IgorFJensen/Hard-EnvSens/TODO.txt

Recomendaçoes para a placa enviroment sensor

Estrutura:
    1- Tirar o chip do esp do meio da placa (antena)
    2- Se caso a proxima placa forem 2 separadas novamente, criar suporte nas extremidades para a plaquinha que fica em cima, pois se forcar ela pode quebrar os headers

Erros na placa ATUAL, lembrar de trocar:
    Utilizar o regulador de tensao 1.8 para alimentar o SHTC1
    Sensor de 1.8 nao funciona e nao descobri o motivo (possivelmente trocar para outro)
    Alimentar o pino VDDH do SGP40
    Trocar os pinos do esp para o esp que vamos utilizar
    Verificar o voltage level translator

Sensores:
