IgorFJensen/Hard-EnvSens/EnvSens-v1.pdf

# Nordic nRF52840

# Sensors

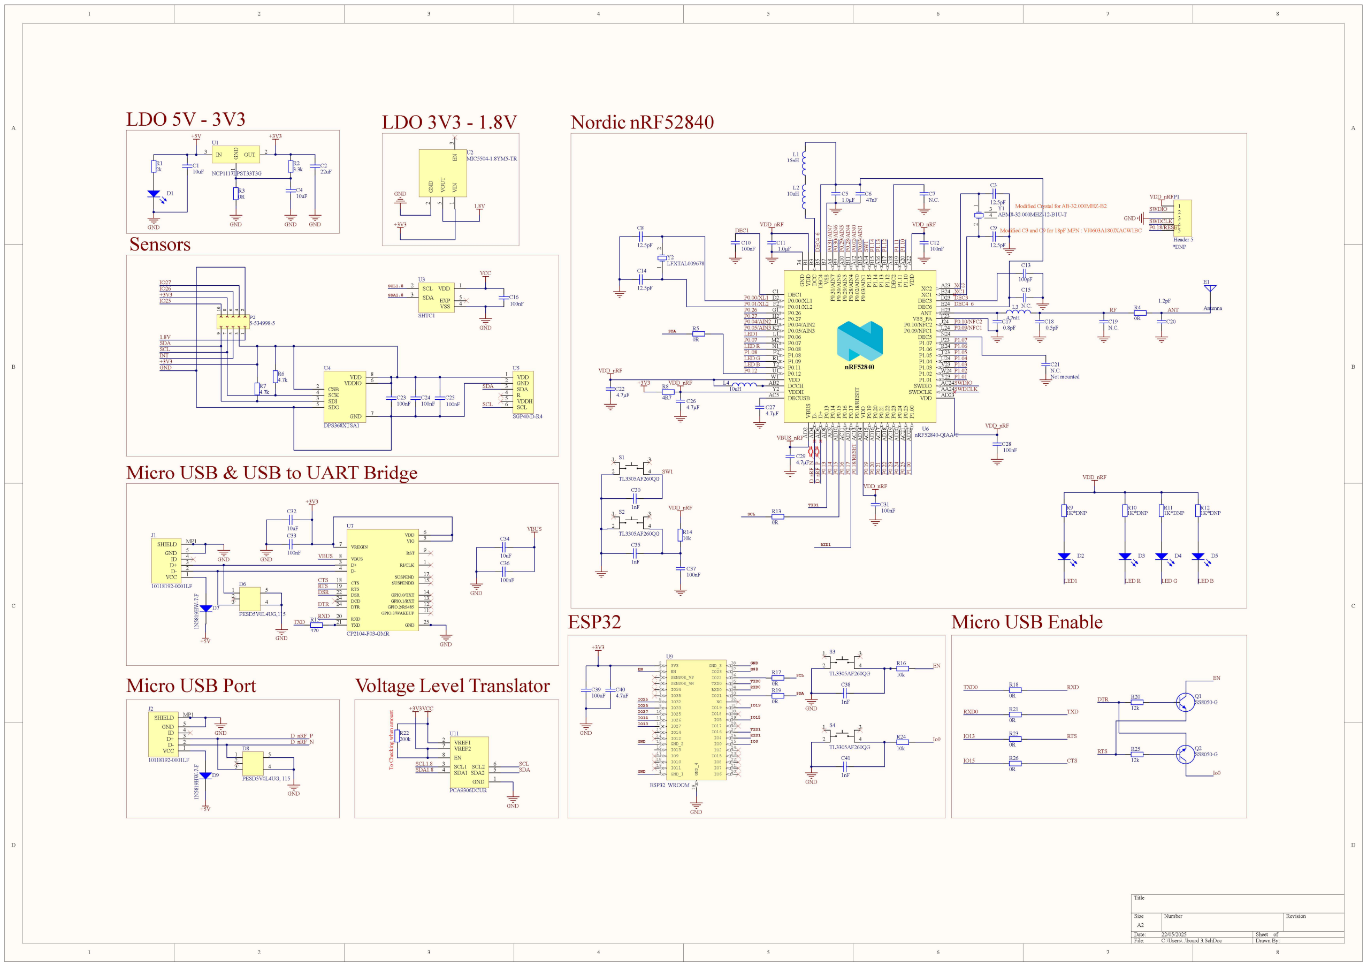
[picture p1: page 1]

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
Title

Size | Number | Revision
A2
Date: | 22/05/2025 | Sheet of
File: | C:\Users\..\board 3.SchDoc | Drawn By:

ANT

1.2pF

C20

DEC1 C1

VDD W1

VSS_PA | F23 ANT | H23 DEC6 | E24 DEC3 | D23 XC1 | B24 XC2 VDD | A23 A²² P¹.10 A²⁰

P0.00/XL1 D2

P0.01/XL2 F2 | P⁰.28/AIN⁴ B¹¹ DEC⁴ B⁵ VSS B⁷ VDD B¹ DCC B³
SWDCLK | AA24 SWDIO | AC24 P1.01 | Y23 D⁻ AD⁴ | P⁰.19 AC¹⁵

### nRF52840

VDDH Y2 | DCCH AB2 | VBUS AD²
DECUSB AC5 | D⁺ AD⁶ | P⁰.20 AD¹⁶ P⁰.21 AC¹⁷ P⁰.22 AD¹⁸ P⁰.23 AC¹⁹ P⁰.24 AD²⁰
VDD | AD23
P0.09/NFC1 | L24
P1.09 R1 | P⁰.25 AC²¹ P¹.00 AD²²

P0.26 G1
P0.27 H2
P0.04/AIN2 J1
P0.05/AIN3 K2
P0.06 L1
P0.07 M2
P0.08 N1
P1.08 P2 | P⁰.13 AD⁸ P⁰.14 AC⁹ P⁰.15 AD¹⁰ P⁰.16 AC¹¹

P0.11 T2
P0.12 U1 | P⁰.17 AD¹² P⁰.18/RESET AC¹³
DEC5 | N24
P0.10/NFC2 | J24 P⁰.03/AIN¹ B¹³ P⁰.02/AIN⁰ A¹² P⁰.29/AIN⁵ A¹⁰ P⁰.30/AIN⁶ B⁹ P⁰.31/AIN⁷ A⁸ | VDD AD¹⁴
P1.02 | W24 P1.03 | V23 P1.04 | U24 P1.05 | T23 P1.06 | R24 P1.07 | P23 P¹.11 B¹⁹ P¹.12 B¹⁷ P¹.13 A¹⁶ P¹.14 B¹⁵ P¹.15 A¹⁴ | DEC² A¹⁸ GND ⁷⁴

U6
nRF52840-QIAA-T

100pF

C13

100nF

C10

4.7µF

C27

XC1

XC2

VDD_nRF

P0.07

P0.10/NFC2

P0.12 | P⁰.18/RESET | P⁰.19 P⁰.20 P⁰.21 P⁰.22 P⁰.23 | P¹.00 P¹.10

DEC1

SWDCLK

SWDIO

1.0µF

C5

0.8pF

C17

C15

N.C.

P0.00/XL1

P0.01/XL2 | P⁰.02/AIN⁰ P⁰.03/AIN¹

VBUS_nRF

VDD_nRF

DEC3

P0.04/AIN2

P0.05/AIN3 | P0.09/NFC1 P¹.14 P¹.13 P¹.12 | P¹.11

VDD_nRF

VDD_nRF

100nF

C31

4.7µF

C29

VDD_nRF

100nF

C28

Not mounted

C21
N.C.
P1.01

P1.02

P1.03

P1.04

P1.05

P1.07

P1.08

P0.26

P0.27 | P⁰.13 P⁰.14 P⁰.15 P⁰.16 P⁰.17 | P⁰.24 P⁰.25

100nF

C12

VDD_nRF

C7

N.C. P⁰.31/AIN⁷ P⁰.30/AIN⁶ P⁰.29/AIN⁵ P⁰.28/AIN⁴

4.7µF

C26

0.5pF

C18

1.0µF

C11

4.7µF

C22

47nF

C6

DEC4_6 DEC⁴_6

RF

C19

N.C. ¹ ²
3
4

Y1
ABM8-32.000MHZ-12-B1U-T

12.5pF

C14 | 1 2 | Y2
| | LFXTAL009678

12.5pF

C8

12.5pF

C9

12.5pF

C3

0R

R5 SDA

0R

R13 SCL

4R7

R8 +3V3

1
2
3
4
5

*DNP

P1

Header 5

VDD_nRF

SWDIO
GND | SWDCLK
| P0.18/RESET

1K*DNP

R10
1K*DNP

R11
1K*DNP

R12
1K*DNP

R9

VDD_nRF

LED1

LED R

LED G
LED B
LED1 | LED R | LED G | LED B

1nF

C30

1nF

C35

SW1

100nF

C37

10k

R14

VDD_nRF

E1

Antenna

0R

R4 D_nRF_N D_nRF_P RXD1 GND

### 2 VIN

### 1 VOUT

# 5 EN

3
U2
MIC5504-1.8YM5-TR

GND

+3V3

1.8V

2

1 3

4

S1

TL3305AF260QG

2

1 3

4

S2

TL3305AF260QG

D2 | D3 | D4 | D5

SCL 2
SDA 3
VDD | 1
VSS | 4
EXP | 5

U3

SHTC1

SCL1.8

SDA1.8

GND

VCC

2

1 3

4

S3

TL3305AF260QG

2

1 3

4

S4

TL3305AF260QG

GND

100nF

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
VDD | 8
VDDIO | 6
GND | 7

CSB 2
SCK 4
SDI 3
SDO 5

U4

DPS368XTSA1 ¹⁰
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
5-534998-5

100nF

C25

VDD 1
GND 2
SDA 3
R

4
VDDH 5
SCL 6

U5

SGP40-D-R4

SDA

100nF | SCL

C24
100nF

C23

IO27
IO26
+3V3
IO25

SDA
SCL
INT
+3V3
GND

TXD0

RXD0

IO13

IO15

RXD

TXD

RTS

CTS

VREF1 2
VREF2 7
EN 8
SCL1 3
SDA1 4
GND | 1
SDA2 | 5
SCL2 | 6

U11

PCA9306DCUR

+3V3VCC

SCL1.8
SDA1.8

SCL
SDA

GND

VREGIN 7

VDD | 6
VIO | 5
RST | 9
VBUS 8
D+ 3
D- 4

RI/CLK 1

CTS 18
RTS 19
DSR 22
DCD 24
DTR 24
GPIO.3/WAKEUP | 11 GPIO.2/RS485 | 12 GPIO.1/RXT | 13 GPIO.0/TXT | 14
SUSPEND | | | | 17
SUSPENDB | | | | 15
TXD 21 | RXD 20
GND | 25

U7

CP2104-F03-GMR

1

3

5
2
4

D6

PESD5V0L4UG,115

SHIELD | MP1
GND | 5
ID | 4
D+ | 3
D- | 2
VCC | 1

J1

10118192-0001LF

GND

+5V | GND

TXD

RXD

DTR

DSR

RTS

CTS

VBUS 100nF

C33

10uF

C32

GND

+3V3

GND

100nF

C36

GND

VBUS

10uF

C34

# Micro USB & USB to UART Bridge

SHIELD | MP1
GND | 5
ID | 4
D+ | 3
D- | 2
VCC | 1

J2

10118192-0001LF

1

3

5
2
4

D8

PESD5V0L4UG, 115

GND

+5V

D_nRF_P
D_nRF_N
Micro USB Port | Voltage Level Translator

GND_1 1

3V3 2
EN 3

GND_2 15

IO11 19
IO6 | 20
IO7 | 21
IO8 | 22
IO15 | 23
IO2 | 24
IO0 | 25
IO4 | 26
IO16 | 27
IO17 | 28
IO5 | 29
IO18 | 30
IO19 | 31
NC | 32
IO21 | 33
RXD0 | 34
TXD0 | 35
IO22 | 36
IO23 | 37
GND_3 | 38 GND_4 39

SENSOR_VP 4
SENSOR_VN 5
IO34 6
IO35 7
IO32 8
IO33 9
IO25 10
IO26 11
IO27 12
IO14 13
IO12 14

IO13 16
IO9 17
IO10 18

U9

ESP32_WROOM

0R

R17

0R

R19

SCL

SDA

TXD0
RXD0

GND
N$8

IO19

IO15

IO0

GND

GND

EN

4.7uF

C40
100uF

C39

GND

GND

+3V3

Q1
SS8050-G

# LDO 3V3 - 1.8V

IN 3 | GND

1

OUT 2

U1

NCP1117LPST33T3G | 22uF C2

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
3.3k

R2

10uF

C4
0R

R3

10uF

C1 2k

R1

D1

+5V | +3V3
GND | GND | GND | GND

# LDO 5V - 3V3

12k

R20

12k

R25 | Q2 SS8050-G

EN

Io0

DTR

RTS

# ESP32

15nH

L1

10uH

L2

4.7nH

L3

10uH

L4

D9 1N⁵⁸¹⁹HW⁻⁷⁻F

D7 1N⁵⁸¹⁹HW⁻⁷⁻F | Micro USB Enable

GND

TXD1

10k

R16

10k

R24

4.7k

R6

4.7k

R7

200k

R22

470

R15 | SW¹

P1.06

1.8V

IO14

IO27

IO26

IO25

IO13
TXD1

RXD1 To Checking when amount

Modified Crystal for AB-32.000MHZ-B2

Modified C3 and C9 for 18pF MPN : VJ0603A180JXACW1BC
