IgorFJensen/Hard-EnvSens/Hard-EnvSens.csv

Reference | Qty | Value | DNP | Exclude from BOM | Exclude from Board | Footprint | Datasheet
1V8,3V3,3V3Sensor1,5vBoost1,5vUSB1,Battery1,GND1,RX1,TX1 | 9 | TestPoint |  |  |  | TestPoint:TestPoint_THTPad_1.5x1.5mm_Drill0.7mm | ~
C1,C4,C13,C22,C28,C29,C36*1 | 7 | 10uF |  |  |  | Capacitor_SMD:C_0603_1608Metric | ~
C2,C12,C16,C18,C19,C23,C30,C31,C32 | 9 | 100nF |  |  |  | Capacitor_SMD:C_0603_1608Metric | ~
C3,C7,C14,C15,C33 | 5 | 1uF |  |  |  | Capacitor_SMD:C_0603_1608Metric | ~
C6,C24 | 2 | 4.7uF |  |  |  | Capacitor_SMD:C_0603_1608Metric | ~
C8,C9,C10,C25,C26,C27 | 6 | 22uF |  |  |  | Capacitor_SMD:C_0603_1608Metric | ~
C17,C38 | 2 | 10nF |  |  |  | Capacitor_SMD:C_0603_1608Metric | ~
C20,C34,C40 | 3 | 0.1uF |  |  |  | Capacitor_SMD:C_0603_1608Metric | ~
C21 | 1 | 0.01uF |  |  |  | Capacitor_SMD:C_0603_1608Metric | ~
C35 | 1 | 1nF |  |  |  | Capacitor_SMD:C_0603_1608Metric | ~
C39 | 1 | 100uF |  |  |  | Capacitor_SMD:C_Elec_6.3x7.7 | ~
D2 | 1 | SP0503BAHT |  |  |  | Package_TO_SOT_SMD:SOT-143 | http://www.littelfuse.com/~/media/files/littelfuse/technical%20resources/documents/data%20sheets/sp05xxba.pdf
D3,D4 | 2 | LED |  |  |  | LED_SMD:LED_0603_1608Metric | ~
D5,D6,D7 | 3 | CMS30I30A |  |  |  | Diode_SMD:D_SMA | https://jlcpcb.com/api/file/downloadByFileSystemAccessId/8590172776373399552,https://jlcpcb.com/api/file/downloadByFileSystemAccessId/8590172776373399552https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
J1 | 1 | TYPE-C-31-M-12 |  |  |  | libs:HRO_TYPE-C-31-M-12
J2 | 1 | Conn_01x04_Socket |  |  |  | Connector_PinSocket_2.54mm:PinSocket_1x04_P2.54mm_Vertical | ~
J3 | 1 | Conn_02x02_Odd_Even |  |  |  | Connector_PinHeader_2.54mm:PinHeader_2x02_P2.54mm_Vertical | ~
J4,J7*1 | 2 | Conn_01x04_Pin |  |  |  | Connector_PinHeader_2.54mm:PinHeader_1x04_P2.54mm_Vertical | ~
J5 | 1 | Conn_02x02_Odd_Even |  |  |  | Connector_PinSocket_2.54mm:PinSocket_2x02_P2.54mm_Vertical | ~
J6 | 1 | Conn_01x02_Pin |  |  |  | Connector_Molex:Molex_KK-254_AE-6410-02A_1x02_P2.54mm_Vertical | ~
L1 | 1 | 1uH |  |  |  | Inductor_SMD:L_TechFuse_SL0630 | ~
MK1 | 1 | ICS-43434 |  |  |  | Sensor_Audio:InvenSense_ICS-43434-6_3.5x2.65mm | https://www.invensense.com/wp-content/uploads/2016/02/DS-000069-ICS-43434-v1.2.pdf
Q1,Q2 | 2 | SS8050 |  |  |  | Package_TO_SOT_SMD:SOT-23 | http://www.secosgmbh.com/datasheet/products/SSMPTransistor/SOT-23/SS8050.pdf
R1,R2,R8,R14,R32*1 | 5 | 10k |  |  |  | Resistor_SMD:R_0603_1608Metric | ~
R3 | 1 | 4.7R |  |  |  | Resistor_SMD:R_0603_1608Metric | ~
R4,R5 | 2 | 4.7k |  |  |  | Resistor_SMD:R_0603_1608Metric | ~
R6,R19 | 2 | 12k |  |  |  | Resistor_SMD:R_0603_1608Metric | ~
R7 | 1 | 100K |  |  |  | Resistor_SMD:R_0603_1608Metric | ~
R9 | 1 | 10R |  |  |  | Resistor_SMD:R_0603_1608Metric | ~
R11,R12 | 2 | 5.11k |  |  |  | Resistor_SMD:R_0603_1608Metric | ~
R13,R21 | 2 | 1k |  |  |  | Resistor_SMD:R_0603_1608Metric | ~
R15 | 1 | 2R |  |  |  | Resistor_SMD:R_0603_1608Metric | ~
R16 | 1 | 0.5R |  |  |  | Resistor_SMD:R_0603_1608Metric | ~
R17,R18,R30*1 | 3 | 0R |  |  |  | Resistor_SMD:R_0603_1608Metric | ~
R20*1 | 1 | 100k |  |  |  | Resistor_SMD:R_0603_1608Metric | ~
R31*1 | 1 | 4k |  |  |  | Resistor_SMD:R_0603_1608Metric | ~
SW1,SW2,SW3 | 3 | SW_Push |  |  |  | libs:Botao KH-6X6X5H-STM | ~
U2 | 1 | ESP32-C6-WROOM-1 |  |  |  | libs:XCVR_ESP32-C6-WROOM-1-N8 | https://www.espressif.com/sites/default/files/documentation/esp32-c6-wroom-1_wroom-1u_datasheet_en.pdf
U3 | 1 | IP5306 |  |  |  | libs:SOP127P600X165-9N
U4 | 1 | VEML7700-TR |  |  |  | libs:XDCR_VEML7700-TR
U5 | 1 | DPS368 |  |  |  | libs:LGA8S145X65P2X4_200X250X110-V
U6 | 1 | SGP41-D-R4 |  |  |  | libs:XDCR_SGP41-D-R4
U7 | 1 | SHT40-AD1B-R2 |  |  |  | libs:SHT4X
U8 | 1 | AS7341-DLGT |  |  |  | Package_LGA:AMS_OLGA-8_2x3.1mm_P0.8mm
U9 | 1 | TPS79318DBVTG4 |  |  |  | libs:SOT95P280X145-5N
U10 | 1 | BMI160 |  |  |  | Package_LGA:Bosch_LGA-14_3x2.5mm_P0.5mm | https://www.bosch-sensortec.com/media/boschsensortec/downloads/datasheets/bst-bmi160-ds000.pdf
U11 | 1 | TPS22918TDBVRQ1 |  |  |  | libs:SOT95P280X145-6N
U12*1 | 1 | TP4056-42-ESOP8 |  |  |  | Package_SO:SOIC-8-1EP_3.9x4.9mm_P1.27mm_EP2.41x3.3mm_ThermalVias | https://www.lcsc.com/datasheet/lcsc_datasheet_2410121619_TOPPOWER-Nanjing-Extension-Microelectronics-TP4056-42-ESOP8_C16581.pdf
U13 | 1 | SPX3819M5-L-3-3 |  |  |  | Package_TO_SOT_SMD:SOT-23-5 | https://www.exar.com/content/document.ashx?id=22106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
