IgorFJensen/Hard-EnvSens/Newsch.pdf

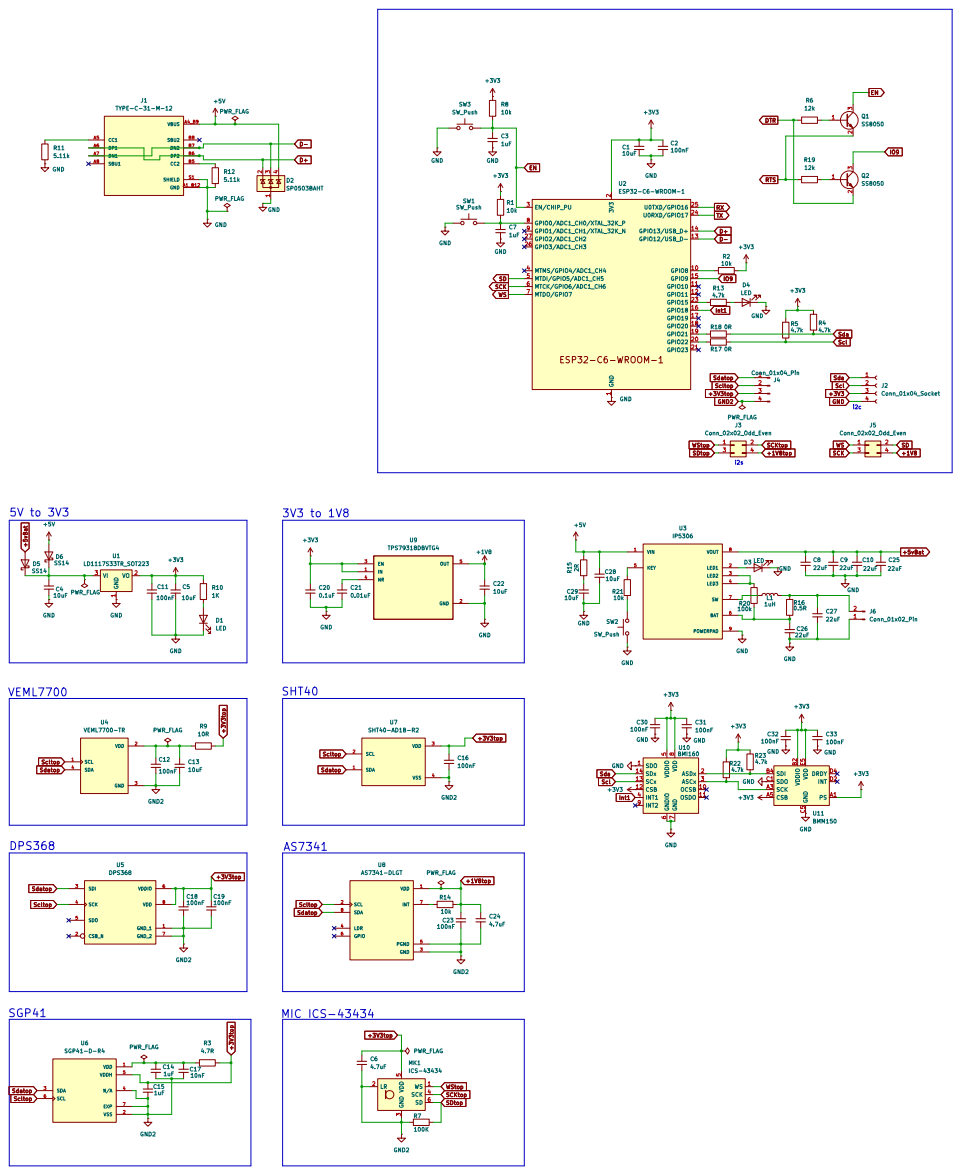
[picture p3: page 1]
