IgorFJensen/Hard-EnvSens/EnvSensTop-v1.pdf

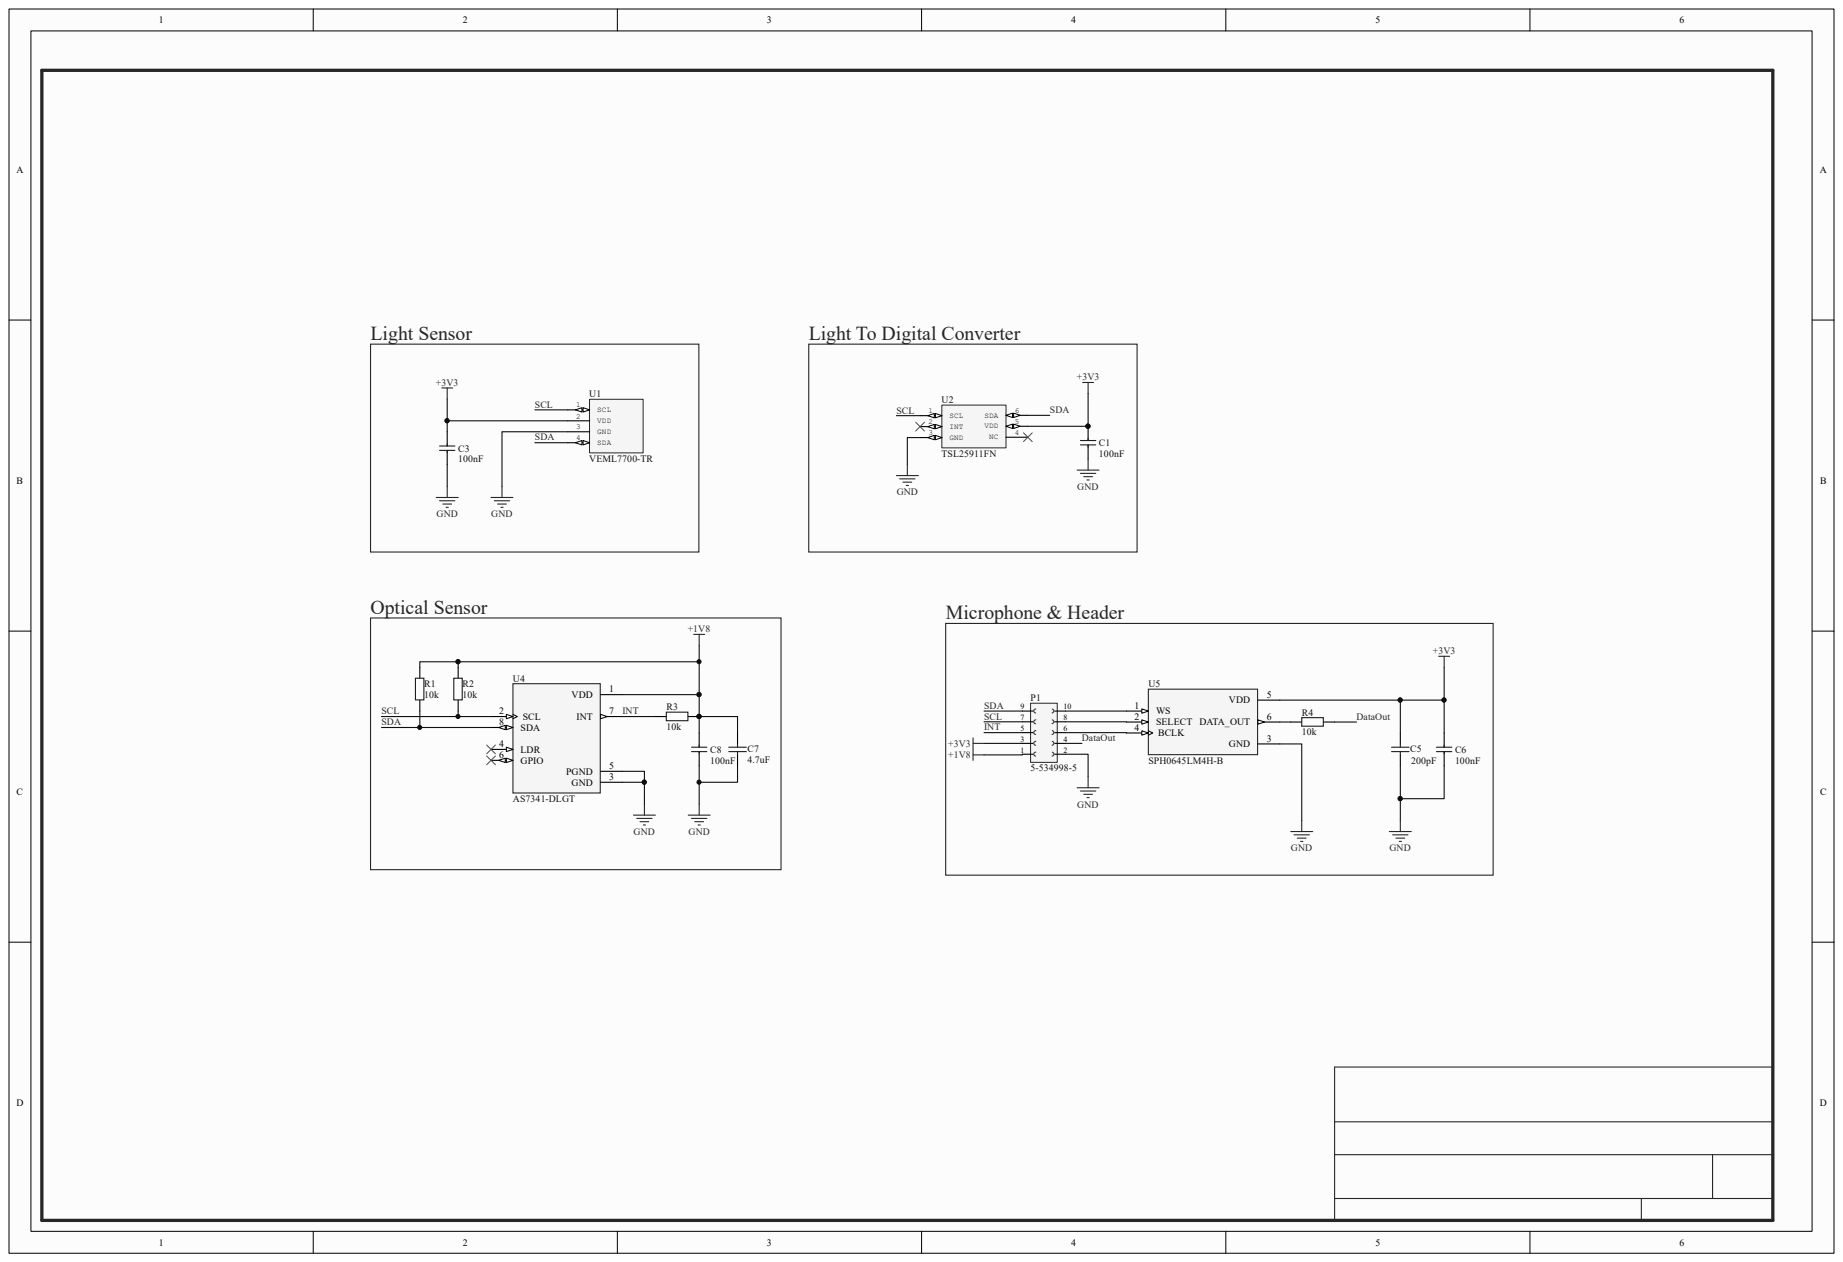
[picture p4: page 1]

Light To Digital Converter
