IgorFJensen/Hard-EnvSens/Hard-EnvSens.kicad_pcb

## KiCad design Hard-EnvSens.kicad_pcb (2026-10-09)

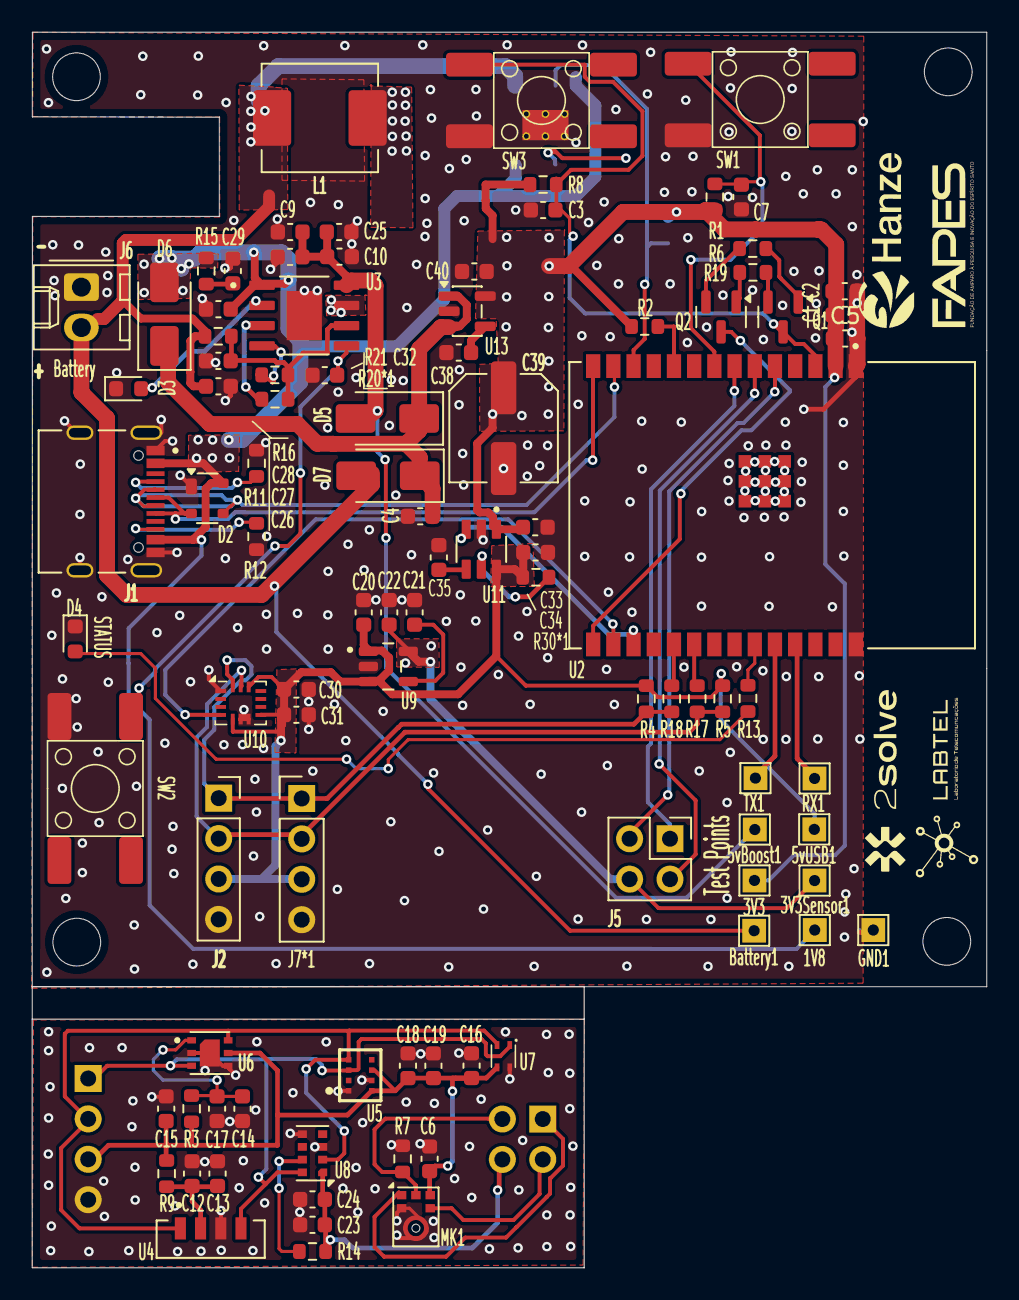
[picture p5: board Hard-EnvSens.kicad_pcb from above]

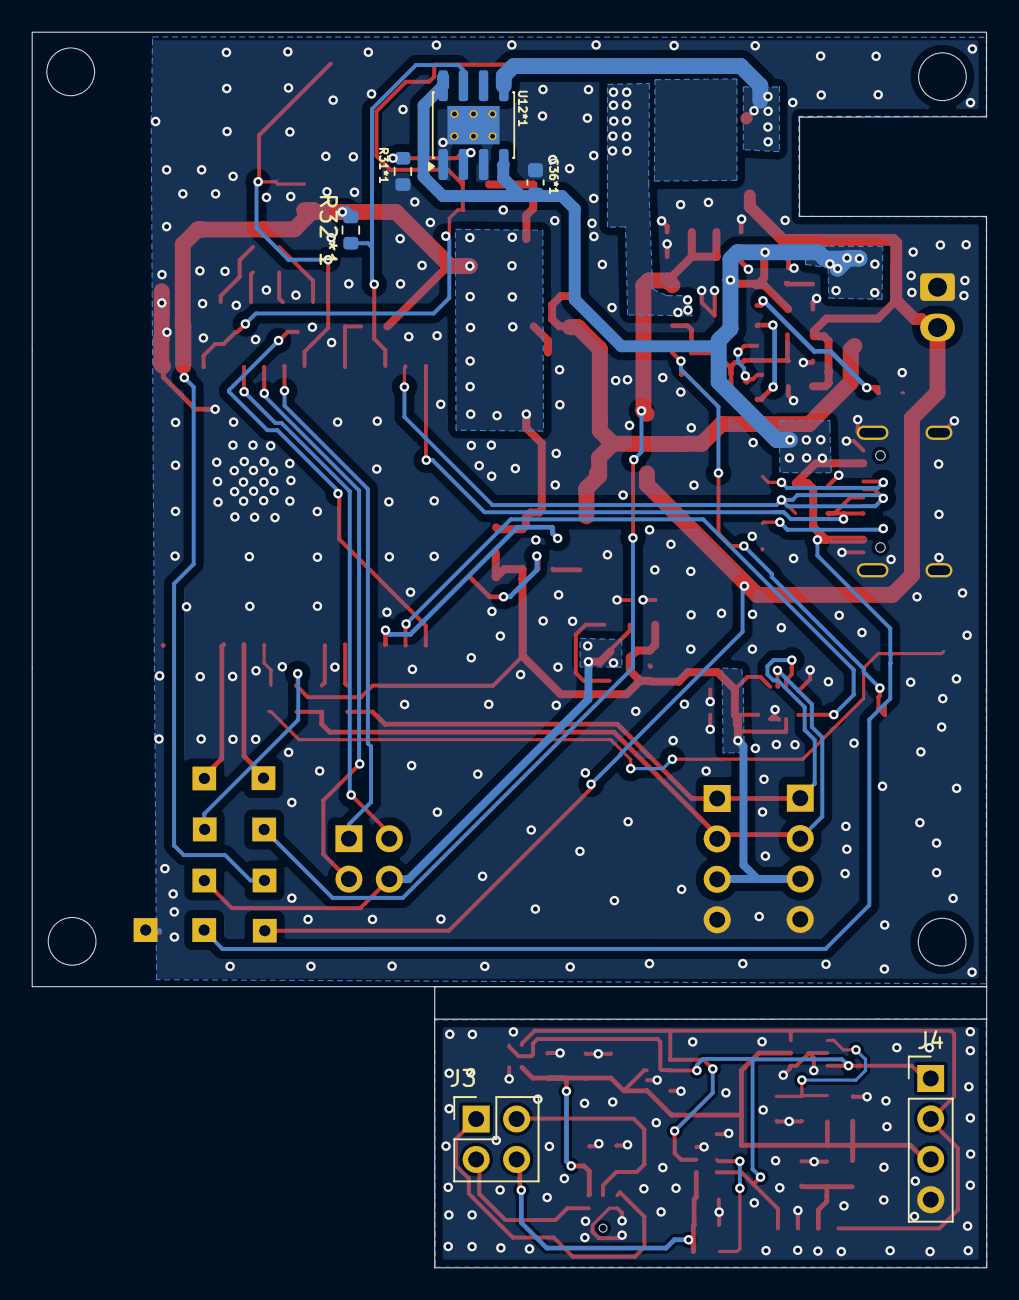
[picture p6: board Hard-EnvSens.kicad_pcb from below]

Board: 2 copper layers, 60.0 x 77.7 mm, 102 parts (6 on the bottom side), 57 nets.

Parts:
1V8, 3V3, 3V3Sensor1, 5vBoost1, 5vUSB1: TestPoint; TestPoint_THTPad_1.5x1.5mm_Drill0.7mm
Battery1: TestPoint; TestPoint_THTPad_1.5x1.5mm_Drill0.7mm
C1, C4, C5, C13, C22, C28, C29, C36*1: 10uF; C_0603_1608Metric
C2, C12, C16, C18, C19, C23, C30, C31, C32: 100nF; C_0603_1608Metric
C3, C7, C14, C15, C33: 1uF; C_0603_1608Metric
C6, C24: 4.7uF; C_0603_1608Metric
C8, C9, C10, C25, C26, C27: 22uF; C_0603_1608Metric
C17, C38: 10nF; C_0603_1608Metric
C20, C34, C40: 0.1uF; C_0603_1608Metric
C21: 0.01uF; C_0603_1608Metric
C35: 1nF; C_0603_1608Metric
C39: 100uF; C_Elec_6.3x7.7
D2: SP0503BAHT; SOT-143
D3, D4: LED; LED_0603_1608Metric
D5, D6, D7: CMS30I30A; D_SMA
GND1: TestPoint; TestPoint_THTPad_1.5x1.5mm_Drill0.7mm
J1: TYPE-C-31-M-12; HRO_TYPE-C-31-M-12
J2: Conn_01x04_Socket; PinSocket_1x04_P2.54mm_Vertical
J3: Conn_02x02_Odd_Even; PinHeader_2x02_P2.54mm_Vertical
J4, J7*1: Conn_01x04_Pin; PinHeader_1x04_P2.54mm_Vertical
J5: Conn_02x02_Odd_Even; PinSocket_2x02_P2.54mm_Vertical
J6: Conn_01x02_Pin; Molex_KK-254_AE-6410-02A_1x02_P2.54mm_Vertical
L1: 1uH; L_TechFuse_SL0630
MK1: ICS-43434; InvenSense_ICS-43434-6_3.5x2.65mm
Q1, Q2: SS8050; SOT-23
R1, R2, R8, R14, R32*1: 10k; R_0603_1608Metric
R3: 4.7R; R_0603_1608Metric
R4, R5: 4.7k; R_0603_1608Metric
R6, R19: 12k; R_0603_1608Metric
R7: 100K; R_0603_1608Metric
R9: 10R; R_0603_1608Metric
R11, R12: 5.11k; R_0603_1608Metric
R13, R21: 1k; R_0603_1608Metric
R15: 2R; R_0603_1608Metric
R16: 0.5R; R_0603_1608Metric
R17, R18, R30*1: 0R; R_0603_1608Metric
R20*1: 100k; R_0603_1608Metric
R31*1: 4k; R_0603_1608Metric
RX1: TestPoint; TestPoint_THTPad_1.5x1.5mm_Drill0.7mm
SW1, SW2, SW3: SW_Push; Botao KH-6X6X5H-STM
TX1: TestPoint; TestPoint_THTPad_1.5x1.5mm_Drill0.7mm
U2: ESP32-C6-WROOM-1; XCVR_ESP32-C6-WROOM-1-N8
U3: IP5306; SOP127P600X165-9N
U4: VEML7700-TR; XDCR_VEML7700-TR
U5: DPS368; LGA8S145X65P2X4_200X250X110-V
U6: SGP41-D-R4; XDCR_SGP41-D-R4
U7: SHT40-AD1B-R2; SHT4X
U8: AS7341-DLGT; AMS_OLGA-8_2x3.1mm_P0.8mm
U9: TPS79318DBVTG4; SOT95P280X145-5N
U10: BMI160; Bosch_LGA-14_3x2.5mm_P0.5mm
U11: TPS22918TDBVRQ1; SOT95P280X145-6N
U12*1: TP4056-42-ESOP8; SOIC-8-1EP_3.9x4.9mm_P1.27mm_EP2.41x3.3mm_ThermalVias
U13: SPX3819M5-L-3-3; SOT-23-5

Connections:
3v3_aux: 3V3Sensor1.1, C20.1, C30.1, C31.1, C34.1, J2.3, J7*1.3, R4.2, R5.2, R30*1.1, U9.1 (IN), U9.3 (EN), U10.5 (VDDIO), U10.8 (VDD), U10.12 (CSB), U11.6 (VOUT)
+1V8: 1V8.1, C22.1, J5.4, U9.5 (OUT)
+1V8top: C23.1, C24.1, J3.4, R14.2, U8.1 (VDD)
+3V3: 3V3.1, C1.1, C2.1, C5.1, C33.1, C39.1, C40.1, R1.1, R2.1, R8.1, R32*1.2, U2.2 (3V3), U11.1 (VIN), U13.5 (OUT)
+3V3top: C6.1, C15.1, C16.1, C18.1, C19.1, J4.3, MK1.5 (VDD), R3.2, R9.2, U5.6 (VDDIO), U5.8 (VDD), U6.5 (VDDH), U7.3 (VDD)
+5V: 5vUSB1.1, C28.1, C36*1.1, D2.4 (K), D6.2 (A), J1.A4_B9 (VBUS), J1.B4_A9 (VBUS), R15.1, U3.1 (VIN), U12*1.4 (V_{CC}), U12*1.8 (CE)
+5vBat: 5vBoost1.1, C8.1, C9.1, C10.1, C25.1, D5.2 (A), U3.8 (VOUT)
Bat+: Battery1.1, C27.1, D7.2 (A), J6.2, L1.2, R16.1, U12*1.5 (BAT)
Charge_Bat: R32*1.1, U2.12 (GPIO11), U12*1.7 (~CHRG)
D+: D2.2 (K), J1.A6 (DP1), J1.B6 (DP2), U2.14 (GPIO13/USB_D+)
D-: D2.3 (K), J1.A7 (DN1), J1.B7 (DN2), U2.13 (GPIO12/USB_D-)
DTR: Q2.2 (E), R6.2
EN: C3.1, Q1.3 (C), R8.2, SW3.2, U2.3 (EN/CHIP_PU)
GND: C1.2, C2.2, C3.2, C4.2, C5.2, C7.2, C8.2, C9.2, C10.2, C20.2, C21.2, C22.2, C25.2, C26.2, C27.2, C28.2, C29.2, C30.2, C31.2, C32.2, C33.2, C34.2, C35.2, C36*1.2, C38.2, C39.2, C40.2, D2.1 (A), D3.1 (K), D4.1 (K), GND1.1, J1.A1_B12 (GND), J1.B1_A12 (GND), J1.S1 (SHIELD), J1.S2 (SHIELD), J1.S3 (SHIELD), J1.S4 (SHIELD), J2.4, J6.1, J7*1.4, R11.2, R12.2, R31*1.2, SW1.1, SW2.1, SW3.1, U2.1 (GND), U2.28 (GND), U3.9 (POWERPAD), U9.2 (GND), U10.1 (SDO), U10.6 (GNDIO), U10.7 (GND), U11.2 (GND), U12*1.1 (TEMP), U12*1.3 (GND), U12*1.9 (EPAD), U13.2 (GND)
GND2: C6.2, C12.2, C13.2, C14.2, C15.2, C16.2, C17.2, C18.2, C19.2, C23.2, C24.2, J4.4, MK1.2 (LR), MK1.3 (GND), R7.1, U4.3 (GND), U5.1 (GND_1), U5.7 (GND_2), U6.2 (VSS), U6.4 (N/A), U6.7 (EXP), U7.4 (VSS), U8.3 (GND), U8.5 (PGND)
IO9: Q2.3 (C), U2.15 (GPIO9)
Int1: U2.16 (GPIO18), U10.4 (INT1)
unnamed: C29.1, R15.2
unnamed: D3.2 (A), U3.2 (LED1)
unnamed: D4.2 (A), R13.1
unnamed: C4.1, D5.1 (K), D6.1 (K), D7.1 (K), U13.1 (IN), U13.3 (EN)
unnamed: J1.A5 (CC1), R11.1
unnamed: J1.B5 (CC2), R12.1
unnamed: Q1.1 (B), R6.1
unnamed: Q2.1 (B), R19.2
unnamed: C7.1, R1.2, SW1.2, U2.8 (GPIO0/ADC1_CH0/XTAL_32K_P)
unnamed: R2.2, U2.10 (GPIO8)
unnamed: R13.2, U2.23 (GPIO15)
unnamed: R18.1, U2.19 (GPIO21)
unnamed: R17.1, U2.20 (GPIO22)
unnamed: C26.1, R16.2, R20*1.2, R21.2, U3.6 (BAT)
unnamed: C32.1, SW2.2, U3.5 (KEY)
unnamed: R20*1.1, U3.3 (LED2)
unnamed: R21.1, U3.4 (LED3)
unnamed: L1.1, U3.7 (SW)
unnamed: C12.1, C13.1, R9.1, U4.2 (VDD)
unnamed: C14.1, C17.1, R3.1, U6.1 (VDD)
unnamed: R14.1, U8.7 (INT)
unnamed: C21.1, U9.4 (NR)
unnamed: C35.1, U11.4 (CT)
unnamed: R30*1.2, U11.5 (QOD)
unnamed: R31*1.1, U12*1.2 (PROG)
unnamed: C38.1, U13.4 (BP)
RTS: Q1.2 (E), R19.1
RX: RX1.1, U2.25 (U0TXD/GPIO16)
SCK: J5.3, U2.6 (MTCK/GPIO6/ADC1_CH6)
SCKtop: J3.3, MK1.4 (SCK)
SD: J5.2, U2.5 (MTDI/GPIO5/ADC1_CH5)
SDtop: J3.2, MK1.6 (SD), R7.2
Scl: J2.2, J7*1.2, R5.1, R17.2, U10.13 (SCx)
Scltop: J4.2, U4.1 (SCL), U5.4 (SCK), U6.6 (SCL), U7.2 (SCL), U8.2 (SCL)
Sda: J2.1, J7*1.1, R4.1, R18.2, U10.14 (SDx)
Sdatop: J4.1, U4.4 (SDA), U5.3 (SDI), U6.3 (SDA), U7.1 (SDA), U8.8 (SDA)
Sensors_3v3: U2.17 (GPIO19), U11.3 (ON)
TX: TX1.1, U2.24 (U0RXD/GPIO17)
WS: J5.1, U2.7 (MTDO/GPIO7)
WStop: J3.1, MK1.1 (WS)
