IgorFJensen/Hard-EnvSens/(commit log)

2025-11-28 Added some sensors
    [Hard-EnvSens.kicad_sch]
2026-01-08 New sensors
    [Hard-EnvSens.kicad_sch]
2026-01-20 Sch done
    [Hard-EnvSens.kicad_sch]
2026-01-22 Schematic done, Bottom board
    [Hard-EnvSens.kicad_pcb, Hard-EnvSens.kicad_sch]
2026-01-29 Started connections and sensors pcb
    [Hard-EnvSens.kicad_pcb, Hard-EnvSens.kicad_sch]
2026-02-04 Full connected board, no charger
    [Hard-EnvSens.kicad_pcb, Hard-EnvSens.kicad_sch]
2026-02-06 Battery charger (not reviewed)
2026-02-12 Baterry charger + giroscope
    Magnetometer not connected
    [Hard-EnvSens.kicad_pcb, Hard-EnvSens.kicad_sch]
2026-02-12 Correct commit for battery charger
    [Hard-EnvSens.kicad_pcb, Hard-EnvSens.kicad_sch]
2026-02-26 Improved whole board design
    [Hard-EnvSens.kicad_pcb, Hard-EnvSens.kicad_sch]
2026-02-26 Lot of improvements
    [Hard-EnvSens.kicad_pcb, Hard-EnvSens.kicad_sch]
2026-03-04 Logos and corrections
    [Hard-EnvSens.kicad_pcb, Hard-EnvSens.kicad_sch]
2026-03-26 New charger + 3v3 Switch
    [Hard-EnvSens.kicad_pcb, Hard-EnvSens.kicad_sch]
2026-03-26 small changes + gotta fix the charger
    Maybe rotating the charger 2 gets a better pin configuration
    [Hard-EnvSens.kicad_pcb, Hard-EnvSens.kicad_sch]
2026-03-26 Almost finished board
    New 3v3 regulaator
    [Hard-EnvSens.kicad_pcb, Hard-EnvSens.kicad_sch]
2026-03-27 Almost ready to fabricate
    [Hard-EnvSens.kicad_pcb, Hard-EnvSens.kicad_sch]
2026-03-27 ready to fabricate
    [Hard-EnvSens.kicad_pcb, Hard-EnvSens.kicad_sch]
